MrH-csv/riscv-single-cycle-soc/(commit log)

2026-03-23 Initial commit: add all Quartus ITESO project files
    [c5_pin_model_dump.txt]
2026-03-24 Add testbenches and Questa run scripts for all 10 IP modules
    Testbenches validate functional correctness of each RISC-V RV32I
    datapath module with pass/fail reporting and waveform-friendly
    verification signals. Includes the control_alu and main_control
    source files that were previously untracked.
    [adder_4_32b_tb.v, alu_riscv_rv32i_tb.v, control_alu_rv32i.v, control_alu_rv32i_tb.v, imm_generator_tb.v, main_control_rv32i.v, main_control_rv32i_tb.v, mul_module_tb.v]
2026-03-29 Add SoC with GPIO memory-mapped peripheral and address decoder
    Refactor rv32i_single_cycle as standalone core with exposed instruction
    and data buses. Add soc_rv32i_single_cycle top-level integrating core,
    ROM, RAM, address decoder, and GPIO peripheral for DE2-115 board.
    - ROM now purely combinational (case statement, synthesizes to LUTs)
    - GPIO: 0x10010024 (LED out 8-bit), 0x10010028 (switch in 8-bit)
    - RESET_VECTOR = 0x00400000 for RARS-compatible addressing
    - Includes LED chaser program, testbenches, and Quartus pin assignments
    [c5_pin_model_dump.txt]
2026-04-02 Add Quartus build files for soc_rv32i_single_cycle
    Add generated Quartus project artifacts for the soc_rv32i_single_cycle IP. Includes many db/hdb/rdb/cmp files, assembler logs, incremental_db compiled partitions, output_files (reports, .sof, .sld, .pin, summaries), the .qsf/.qws project files, and Questa/ModelSim simulation/work artifacts. These are generated build outputs from Quartus/ModelSim runs.
2026-04-02 Restructure project: rename ip_modules to rtl, remove SoC build artifacts, update README
    [c5_pin_model_dump.txt]
